kecajtop/ESPhome_led_stairs_controller/README.md

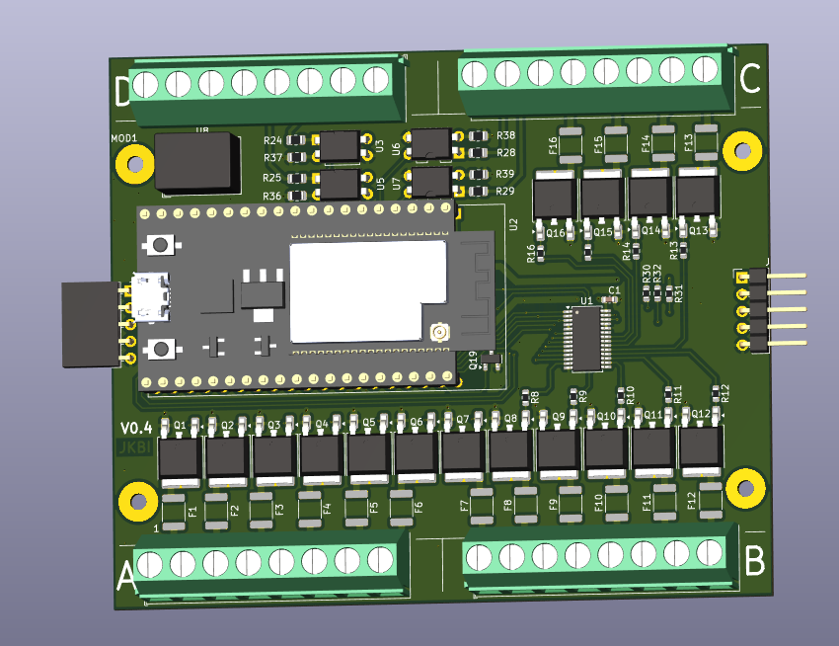
[picture p1: pic/View1.PNG]

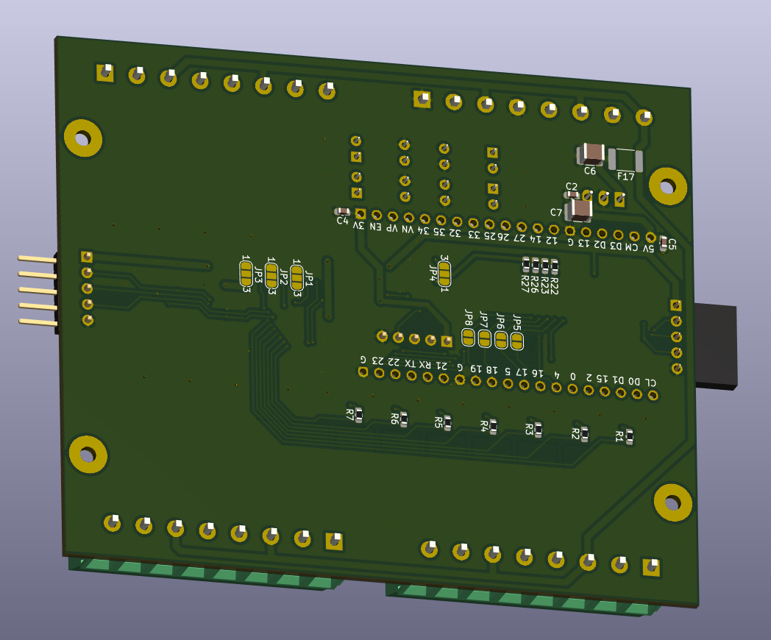
[picture p2: pic/View2.PNG]
