kecajtop/ESPhome_led_stairs_controller/pic/ESP32_boot_pins.png

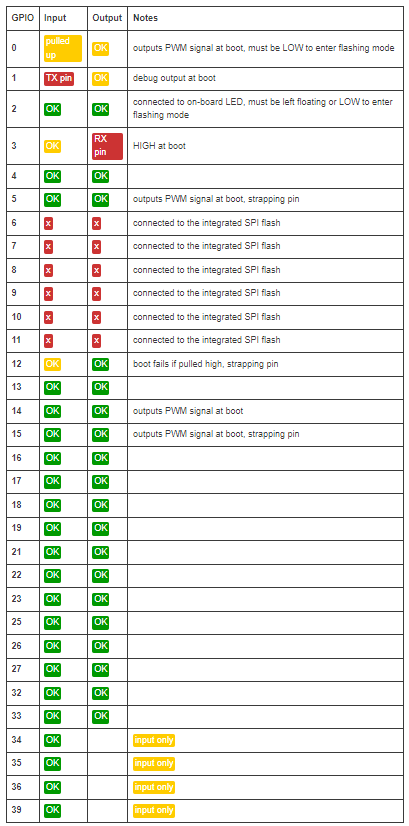
pic/ESP32_boot_pins.png
