kecajtop/ESPhome_led_stairs_controller/pic/ESP32_pinout.PNG

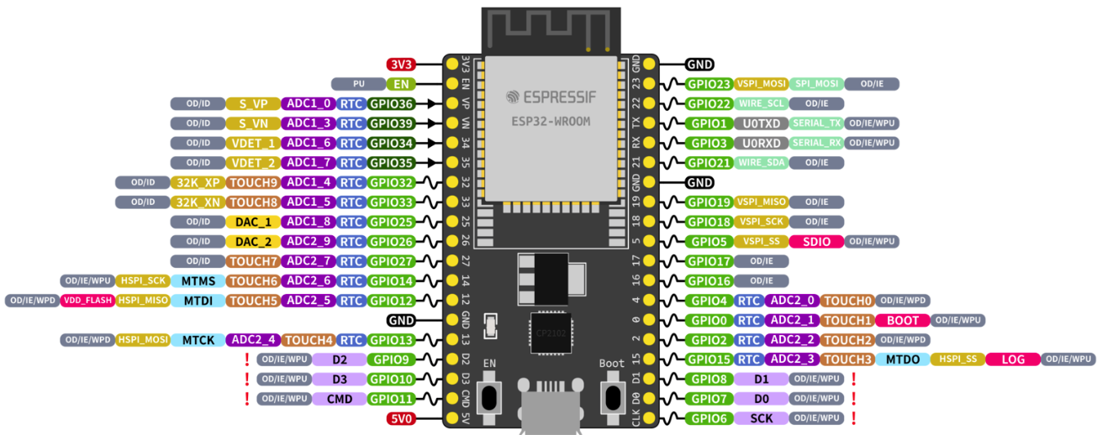
pic/ESP32_pinout.PNG
