kecajtop/ESPhome_led_stairs_controller/doc/ZD1006_Enclosure_components.pdf

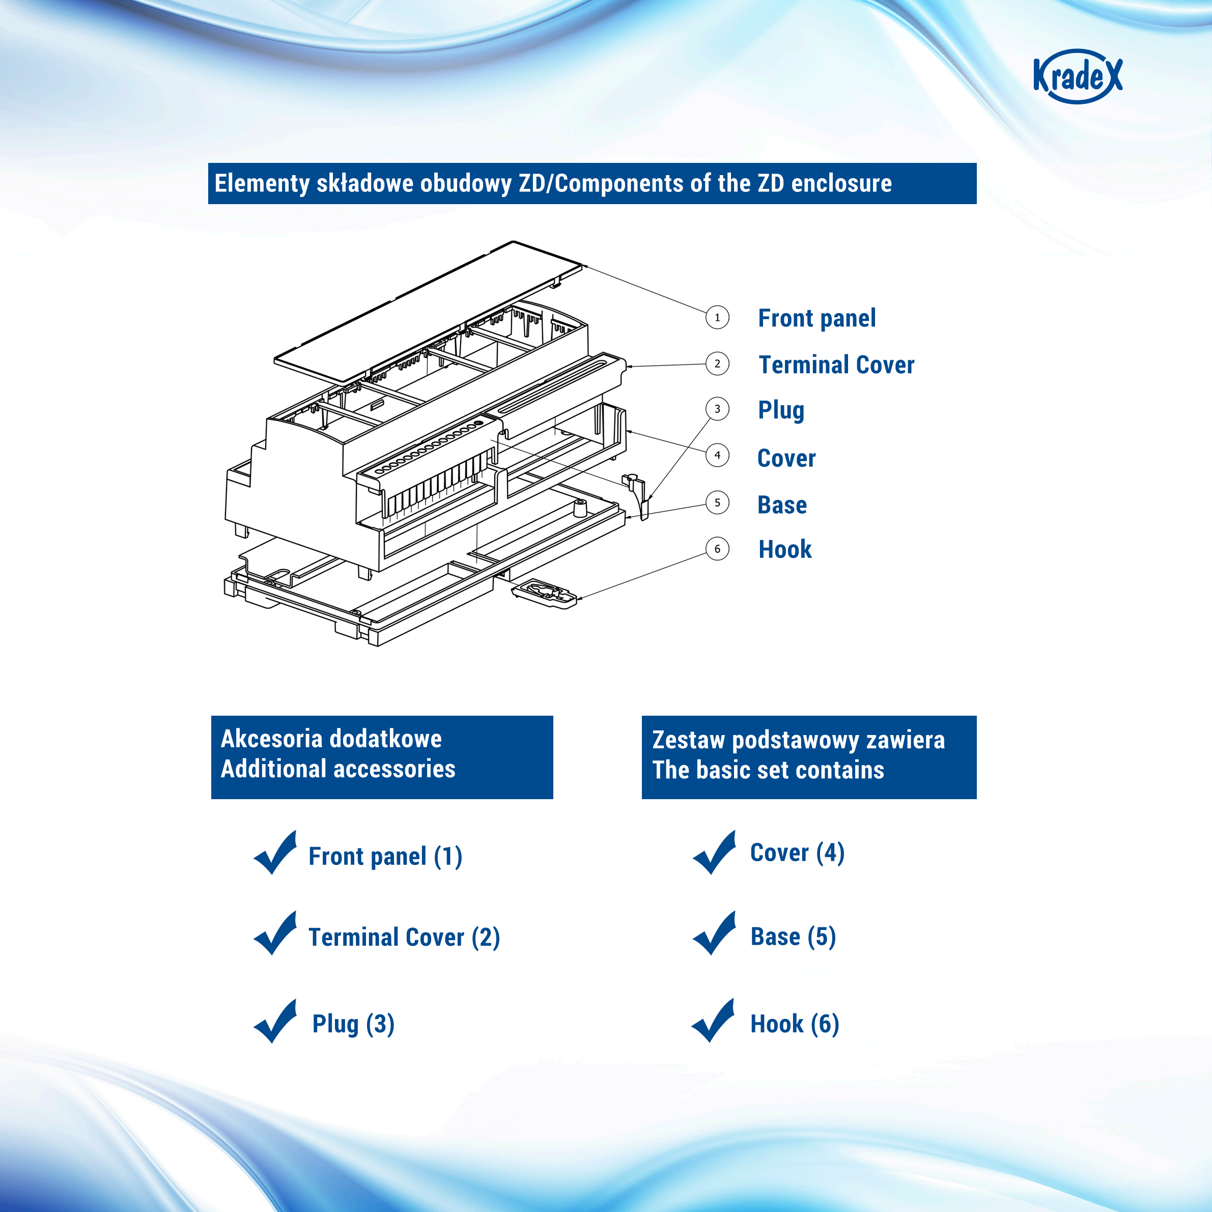
[picture p5: page 1]

Frontpanel
TerminalCover
Plug
Cover
Base
Hook

ElementyskładoweobudowyZD/ComponentsoftheZDenclosure

Cover(4)

Base(5)

Hook(6)

Zestawpodstawowyzawiera
Thebasicsetcontains

Frontpanel(1)

TerminalCover(2)

Plug(3)

Akcesoriadodatkowe
Additionalaccessories
