kecajtop/ESPhome_led_stairs_controller/hardware/schemat/V0.4/led_stairs_controller.pdf

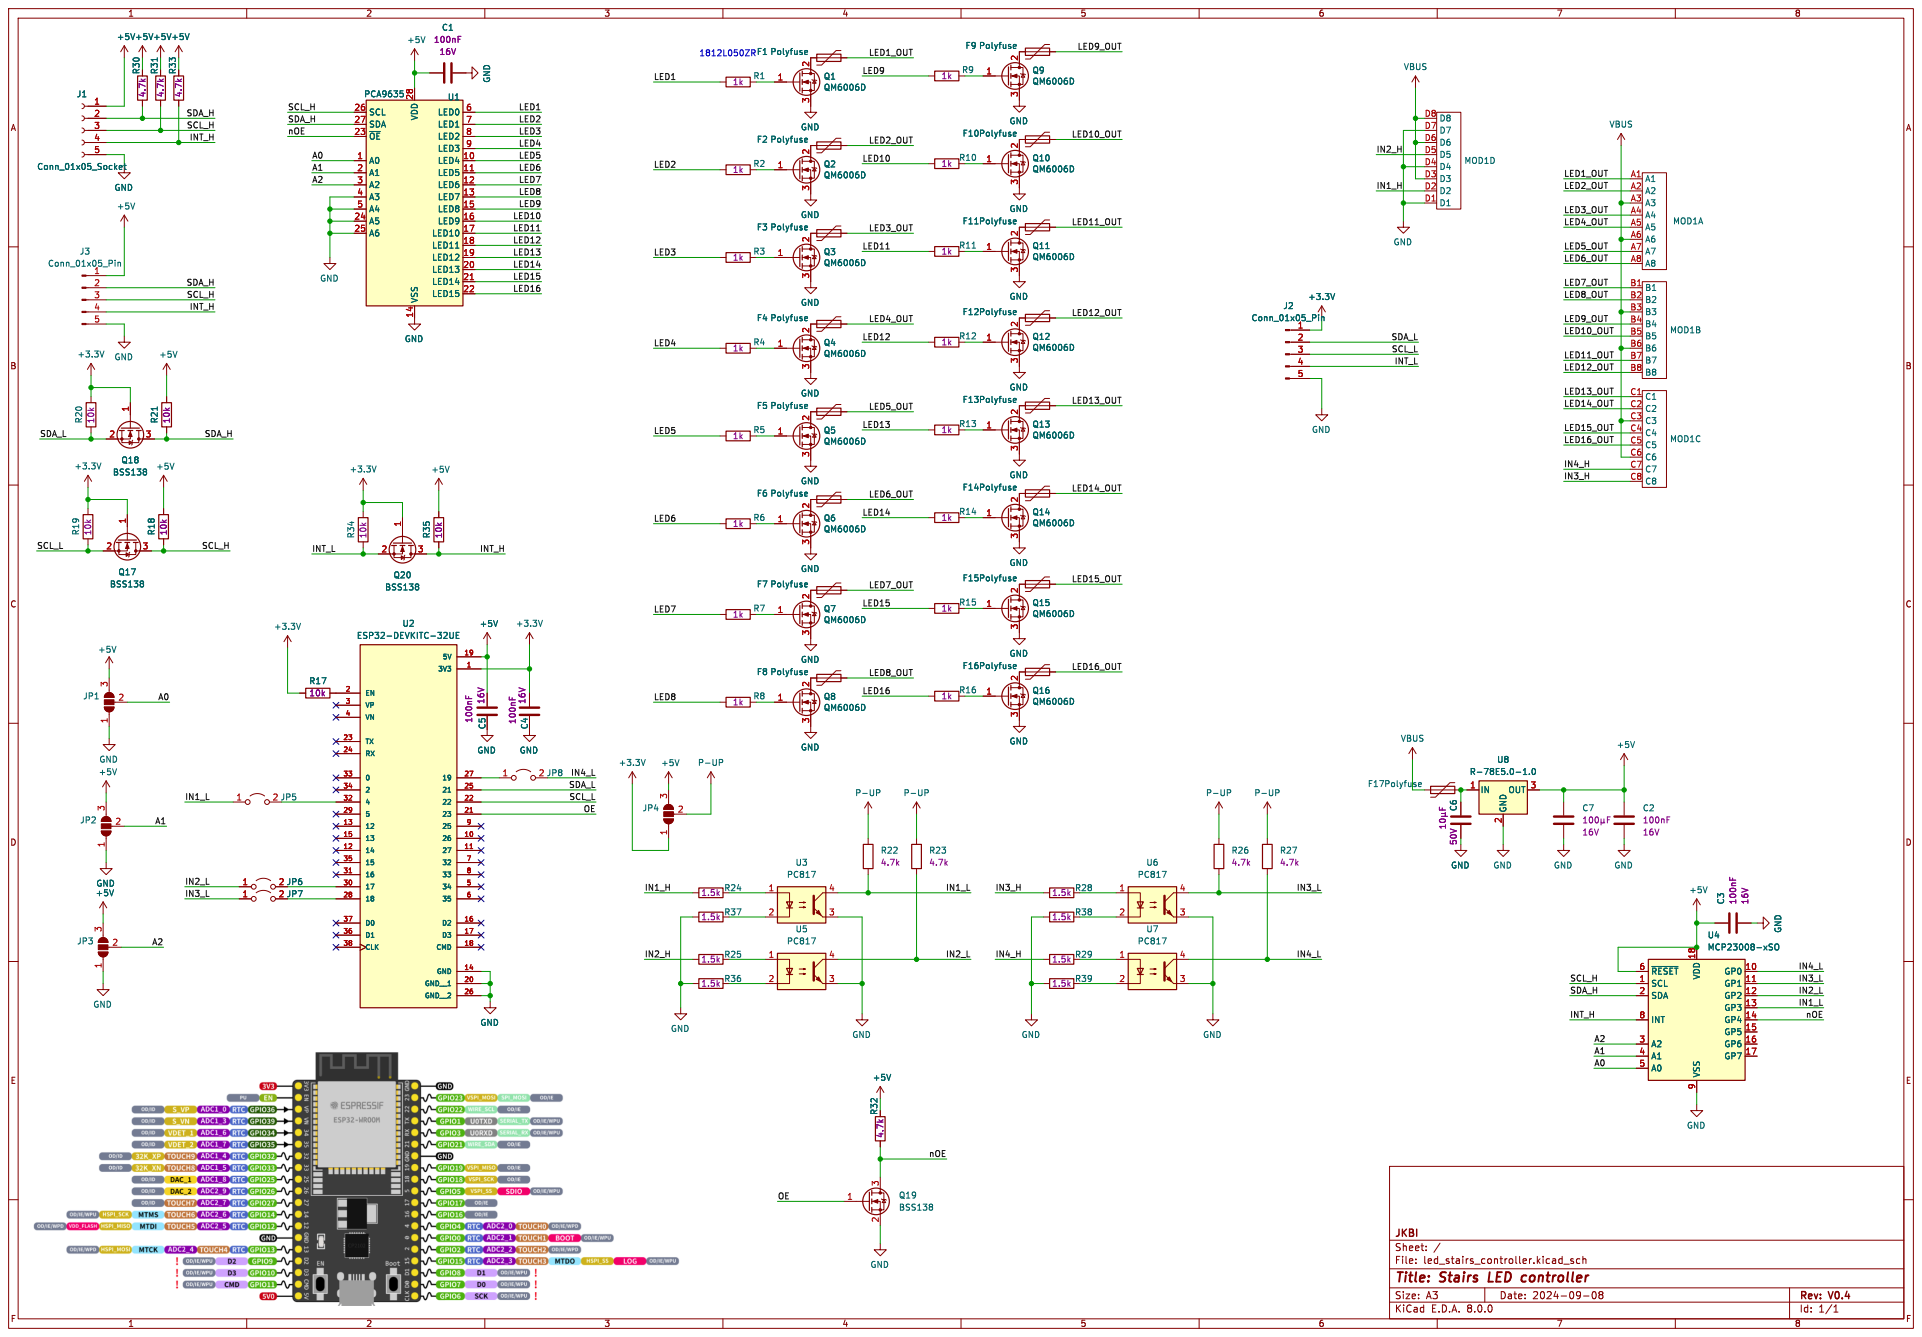
[picture p6: page 1]
