kecajtop/ESPhome_led_stairs_controller/doc/PŁYTKA_UNIWERSALNA_serii_ZD.pdf

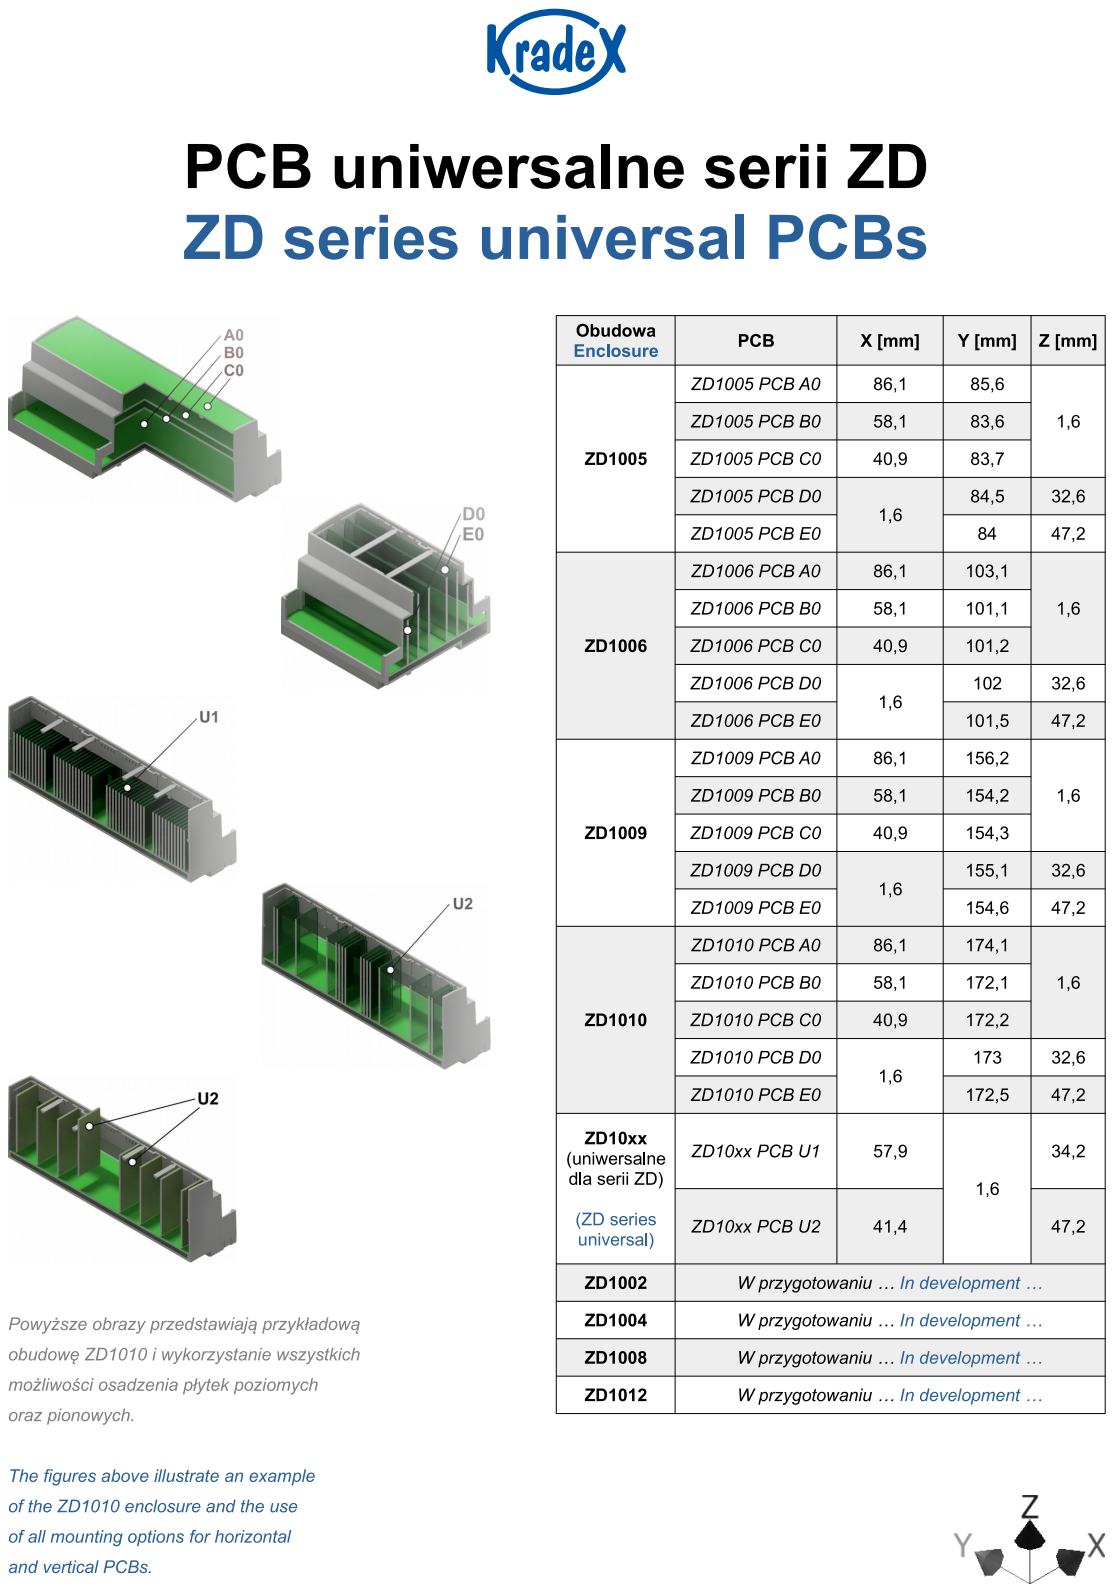
[picture p7: page 1]

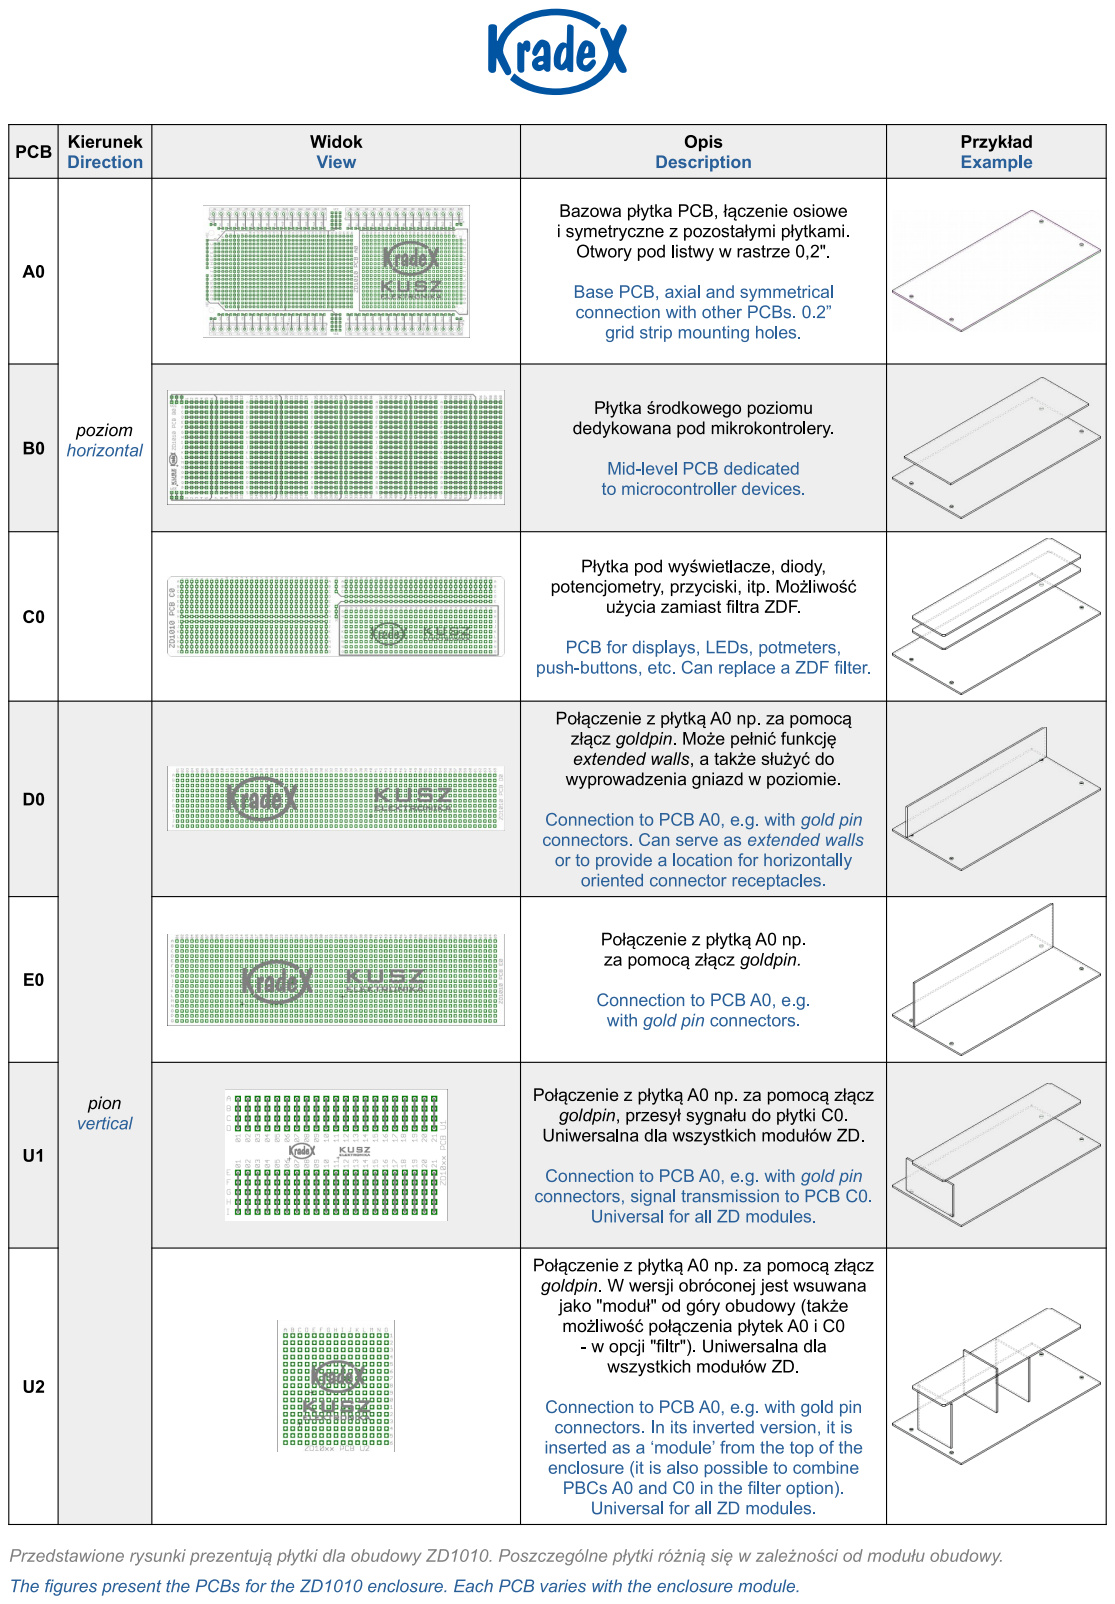
[picture p8: page 2]
