kecajtop/ESPhome_led_stairs_controller/hardware/led_stairs_controller.kicad_pcb

## KiCad design hardware/led_stairs_controller.kicad_pcb (2024-09-08)

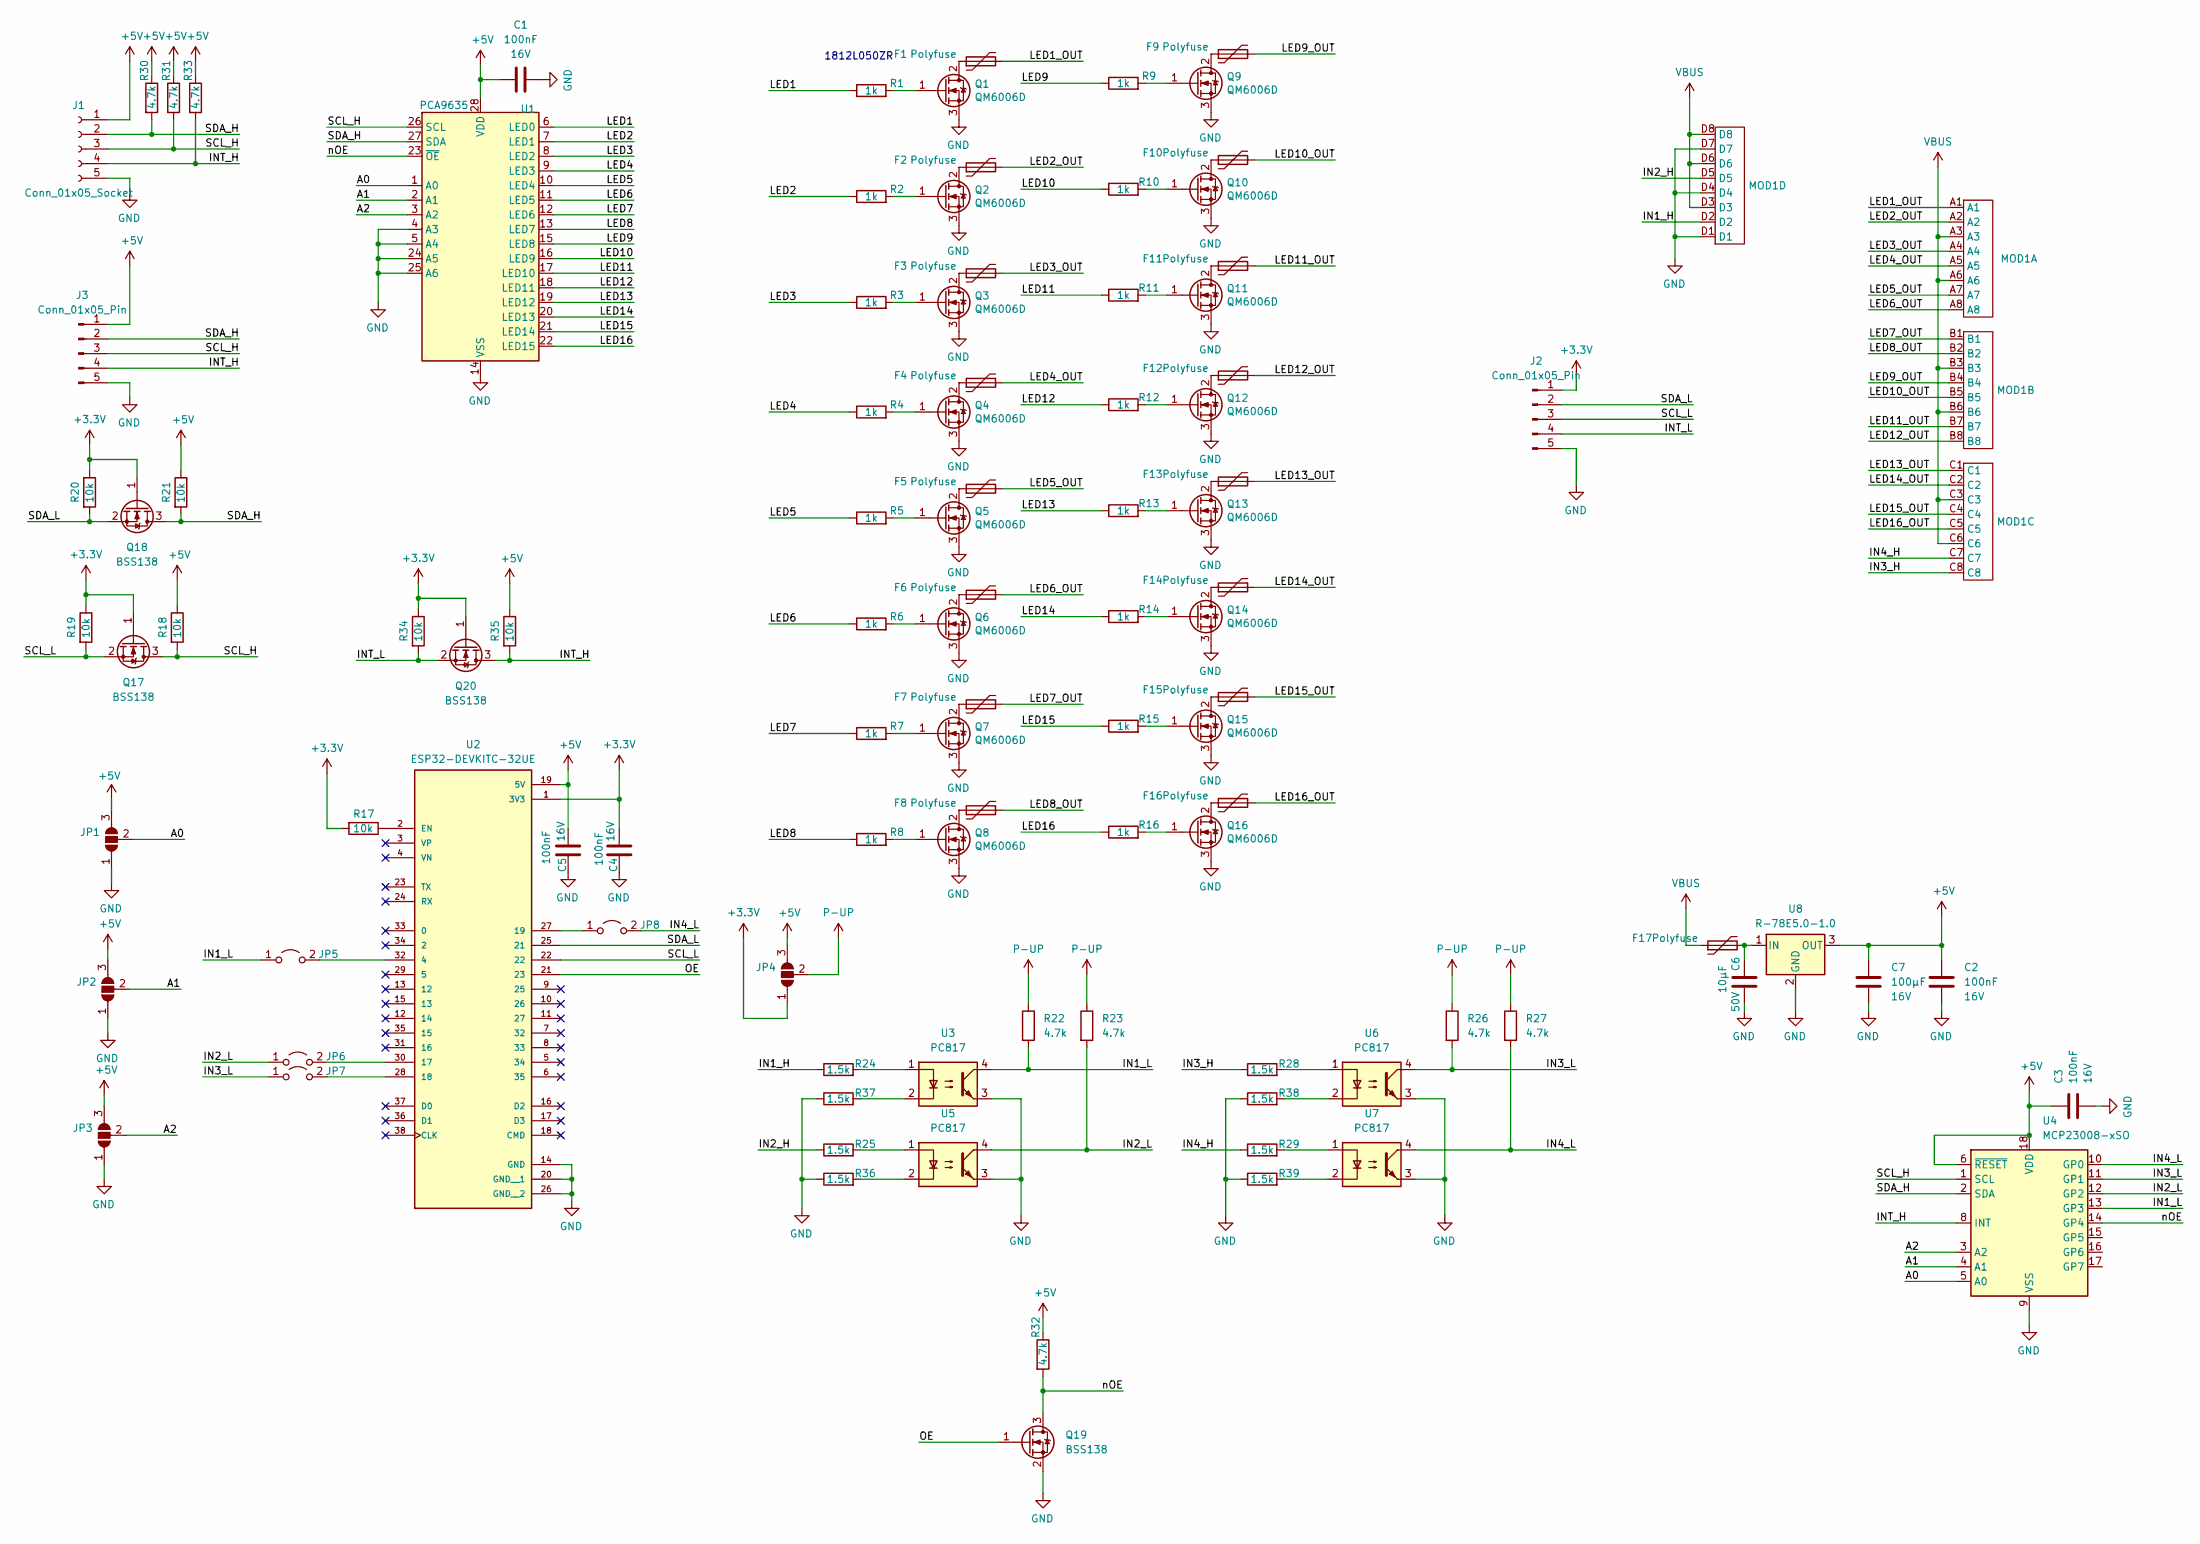
[picture p9: schematic led_stairs_controller.kicad_sch, Stairs LED controller]

Parts:
C1, C2, C3, C4, C5: C0603_100nF_16V_X7R; C_0603_1608Metric; Voltage 16V; Manufacturer Part Number C0603C104J4RACTU
C6: C1210_10µF_50V_X5R; C_1210_3225Metric; Voltage 50V; Manufacturer Part Number C1210C106K5PAC7210
C7: C1210_100µF_16V_X5R; C_1210_3225Metric; Voltage 16V; Manufacturer Part Number C1210C107M4PAC7800
F1, F2, F3, F4, F5, F6, F7, F8, F9, F10, F11, F12, F13, F14, F15, F16, F17: Polyfuse; Fuse_1812_4532Metric
J1: Conn_01x05_Socket; PinSocket_1x05_P2.54mm_Horizontal
J2: Conn_01x05_Pin; PinHeader_1x05_P2.54mm_Vertical
J3: Conn_01x05_Pin; PinHeader_1x05_P2.54mm_Horizontal
JP1, JP2, JP3, JP4: SolderJumper_3_Open; SolderJumper-3_P1.3mm_Open_RoundedPad1.0x1.5mm_NumberLabels
JP5, JP6, JP7, JP8: Jumper_2_Open; SolderJumper-2_P1.3mm_Open_RoundedPad1.0x1.5mm
MOD1: ZD1006
Q1, Q2, Q3, Q4, Q5, Q6, Q7, Q8, Q9, Q10, Q11, Q12, Q13, Q14, Q15, Q16: QM6006D; TO-252-2
Q17, Q18, Q19, Q20: BSS138; SOT-23
R1, R2, R3, R4, R5, R6, R7, R8, R9, R10, R11, R12, R13, R14, R15, R16: R0603_1k_1%_100mW_100PPM_AC; R_0603_1608Metric; Manufacturer Part Number AC0603FR-071KL
R17, R18, R19, R20, R21, R34, R35: R0603_10k_1%_100mW_100PPM_AC; R_0603_1608Metric; Manufacturer Part Number AC0603FR-0710KL
R22, R23, R26, R27, R30, R31, R32, R33: R0603_4.7k_1%_100mW_100PPM_AC; R_0603_1608Metric; Manufacturer Part Number AC0603FR-074K7L
R24, R25, R28, R29, R36, R37, R38, R39: R0805_1.5k_1%_125mW_100PPM_AC; R_0805_2012Metric; Manufacturer Part Number AC0805FR-071K5L
U1: PCA9635; TSSOP-28_4.4x9.7mm_P0.65mm
U2: ESP32-DEVKITC-32UE; ESPRESSIF_ESP32-DEVKITC-32UE; PARTREV V4
U3, U5, U6, U7: PC817; DIP-4_W7.62mm
U4: MCP23008-xSO; SOIC-18W_7.5x11.6mm_P1.27mm
U8: R-78E5.0-1.0; Converter_DCDC_RECOM_R-78E-0.5_THT

Connections:
+3.3V: C4.1, J2.1, JP4.1 (A), Q17.1 (G), Q18.1 (G), Q20.1 (G), R17.2, R19.1, R20.1, R34.1, U2.1 (3V3)
+5V: C1.1, C2.2, C3.2, C5.1, C7.1, J1.1, J3.1, JP1.3 (B), JP2.3 (B), JP3.3 (B), JP4.3 (B), R18.1, R21.1, R30.1, R31.1, R32.1, R33.1, R35.1, U1.28 (VDD), U2.19 (5V), U4.6 (~RESET), U4.18 (VDD), U8.3 (OUT)
/A0: JP1.2 (C), U1.1 (A0), U4.5 (A0)
/A1: JP2.2 (C), U1.2 (A1), U4.4 (A1)
/A2: JP3.2 (C), U1.3 (A2), U4.3 (A2)
/IN1_H: MOD1.D2, R24.1
/IN1_L: JP5.1 (A), R22.2, U3.4, U4.13 (GP3)
/IN2_H: MOD1.D5, R25.1
/IN2_L: JP6.1 (A), R23.2, U4.12 (GP2), U5.4
/IN3_H: MOD1.C8, R28.1
/IN3_L: JP7.1 (A), R26.2, U4.11 (GP1), U6.4
/IN4_H: MOD1.C7, R29.1
/IN4_L: JP8.2 (B), R27.2, U4.10 (GP0), U7.4
/INT_H: J1.4, J3.4, Q20.3 (D), R33.2, R35.2, U4.8 (INT)
/INT_L: J2.4, Q20.2 (S), R34.2
/LED1: R1.1, U1.6 (LED0)
/LED1_OUT: F1.2, MOD1.A1
/LED2: R2.1, U1.7 (LED1)
/LED2_OUT: F2.2, MOD1.A2
/LED3: R3.1, U1.8 (LED2)
/LED3_OUT: F3.2, MOD1.A4
/LED4: R4.1, U1.9 (LED3)
/LED4_OUT: F4.2, MOD1.A5
/LED5: R5.1, U1.10 (LED4)
/LED5_OUT: F5.2, MOD1.A7
/LED6: R6.1, U1.11 (LED5)
/LED6_OUT: F6.2, MOD1.A8
/LED7: R7.1, U1.12 (LED6)
/LED7_OUT: F7.2, MOD1.B1
/LED8: R8.1, U1.13 (LED7)
/LED8_OUT: F8.2, MOD1.B2
/LED9: R9.1, U1.15 (LED8)
/LED9_OUT: F9.2, MOD1.B4
/LED10: R10.1, U1.16 (LED9)
/LED10_OUT: F10.2, MOD1.B5
/LED11: R11.1, U1.17 (LED10)
/LED11_OUT: F11.2, MOD1.B7
/LED12: R12.1, U1.18 (LED11)
/LED12_OUT: F12.2, MOD1.B8
/LED13: R13.1, U1.19 (LED12)
/LED13_OUT: F13.2, MOD1.C1
/LED14: R14.1, U1.20 (LED13)
/LED14_OUT: F14.2, MOD1.C2
/LED15: R15.1, U1.21 (LED14)
/LED15_OUT: F15.2, MOD1.C4
/LED16: R16.1, U1.22 (LED15)
/LED16_OUT: F16.2, MOD1.C5
/OE: Q19.1 (G), U2.21 (23)
/SCL_H: J1.3, J3.3, Q17.3 (D), R18.2, R31.2, U1.26 (SCL), U4.1 (SCL)
/SCL_L: J2.3, Q17.2 (S), R19.2, U2.22
/SDA_H: J1.2, J3.2, Q18.3 (D), R21.2, R30.2, U1.27 (SDA), U4.2 (SDA)
/SDA_L: J2.2, Q18.2 (S), R20.2, U2.25 (21)
/nOE: Q19.3 (D), R32.2, U1.23 (~OE), U4.14 (GP4)
GND: C1.2, C2.1, C3.1, C4.2, C5.2, C6.2, C7.2, J1.5, J2.5, J3.5, JP1.1 (A), JP2.1 (A), JP3.1 (A), MOD1.D1, MOD1.D4, MOD1.D7, Q1.3 (S), Q2.3 (S), Q3.3 (S), Q4.3 (S), Q5.3 (S), Q6.3 (S), Q7.3 (S), Q8.3 (S), Q9.3 (S), Q10.3 (S), Q11.3 (S), Q12.3 (S), Q13.3 (S), Q14.3 (S), Q15.3 (S), Q16.3 (S), Q19.2 (S), R36.1, R37.1, R38.1, R39.1, U1.4 (A3), U1.5 (A4), U1.14 (VSS), U1.24 (A5), U1.25 (A6), U2.14 (GND), U2.20 (GND__1), U2.26 (GND__2), U3.3, U4.9 (VSS), U5.3, U6.3, U7.3, U8.2 (GND)
unnamed: JP5.2 (B), U2.32 (4)
unnamed: JP6.2 (B), U2.30 (17)
unnamed: JP7.2 (B), U2.28 (18)
unnamed: JP8.1 (A), U2.27 (19)
unnamed: F1.1, Q1.2 (D)
unnamed: Q1.1 (G), R1.2
unnamed: F2.1, Q2.2 (D)
unnamed: Q2.1 (G), R2.2
unnamed: F3.1, Q3.2 (D)
unnamed: Q3.1 (G), R3.2
unnamed: F4.1, Q4.2 (D)
unnamed: Q4.1 (G), R4.2
unnamed: F5.1, Q5.2 (D)
unnamed: Q5.1 (G), R5.2
unnamed: F6.1, Q6.2 (D)
unnamed: Q6.1 (G), R6.2
unnamed: F7.1, Q7.2 (D)
unnamed: Q7.1 (G), R7.2
unnamed: F8.1, Q8.2 (D)
unnamed: Q8.1 (G), R8.2
unnamed: F9.1, Q9.2 (D)
unnamed: Q9.1 (G), R9.2
unnamed: F10.1, Q10.2 (D)
unnamed: Q10.1 (G), R10.2
unnamed: F11.1, Q11.2 (D)
unnamed: Q11.1 (G), R11.2
unnamed: F12.1, Q12.2 (D)
unnamed: Q12.1 (G), R12.2
unnamed: F13.1, Q13.2 (D)
unnamed: Q13.1 (G), R13.2
unnamed: F14.1, Q14.2 (D)
unnamed: Q14.1 (G), R14.2
unnamed: F15.1, Q15.2 (D)
unnamed: Q15.1 (G), R15.2
unnamed: F16.1, Q16.2 (D)
unnamed: Q16.1 (G), R16.2
unnamed: R24.2, U3.1
unnamed: R25.2, U5.1
unnamed: R28.2, U6.1
unnamed: R29.2, U7.1
unnamed: R36.2, U5.2
unnamed: R37.2, U3.2
unnamed: R38.2, U6.2
unnamed: R39.2, U7.2
unnamed: R17.1, U2.2 (EN)
unnamed: C6.1, F17.2, U8.1 (IN)
P-UP: JP4.2 (C), R22.1, R23.1, R26.1, R27.1
VBUS: F17.1, MOD1.A3, MOD1.A6, MOD1.B3, MOD1.B6, MOD1.C3, MOD1.C6, MOD1.D3, MOD1.D6, MOD1.D8

Notes on the sheet:
1812L050ZR

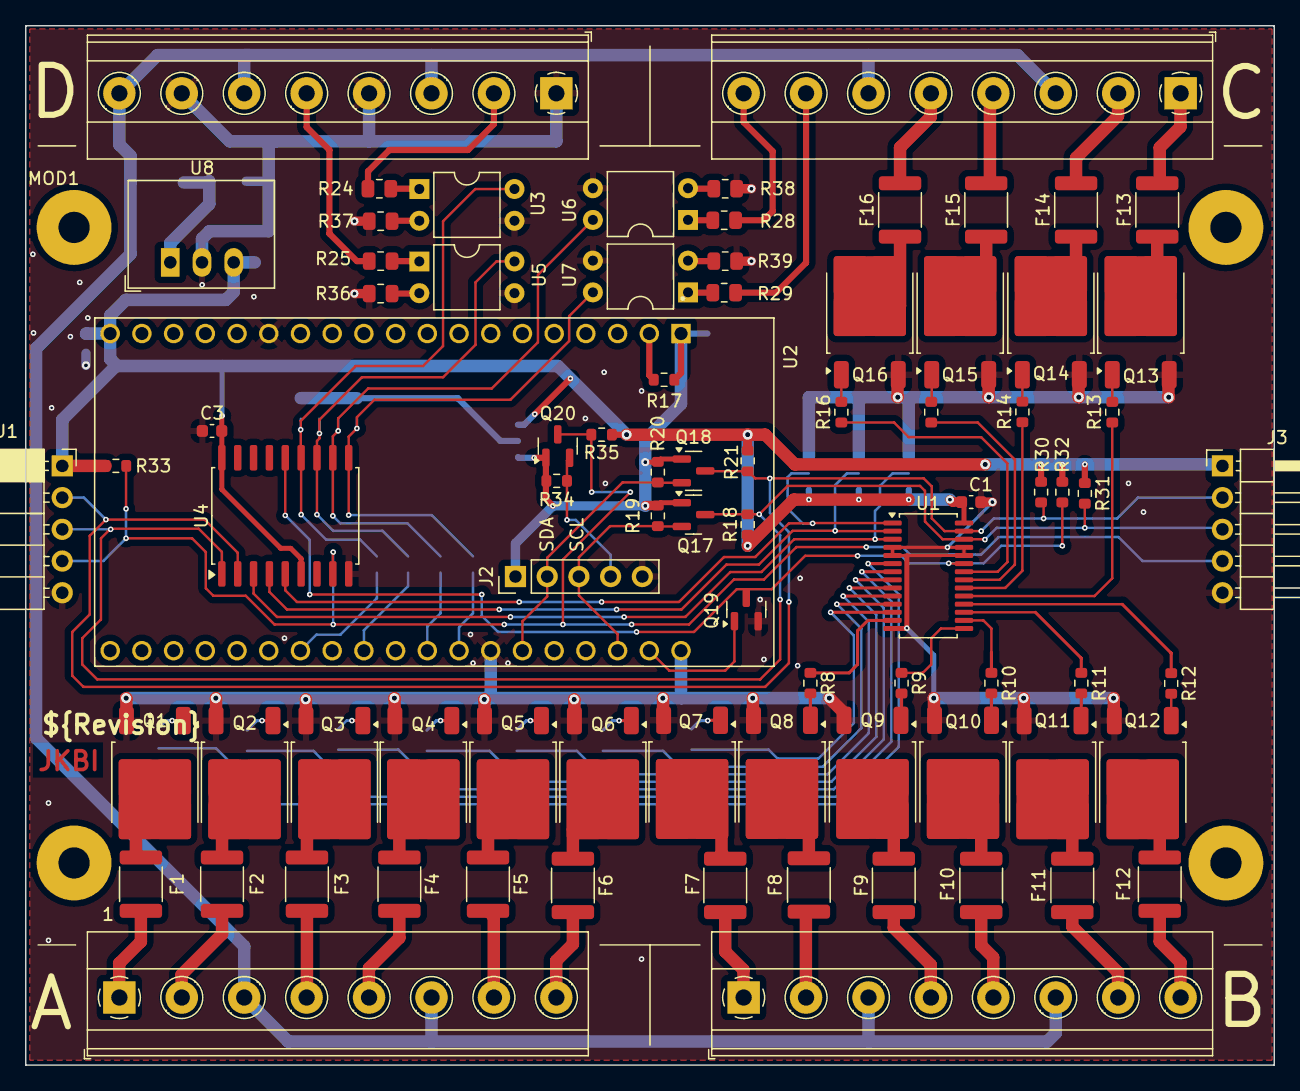
[picture p10: board led_stairs_controller.kicad_pcb from above]

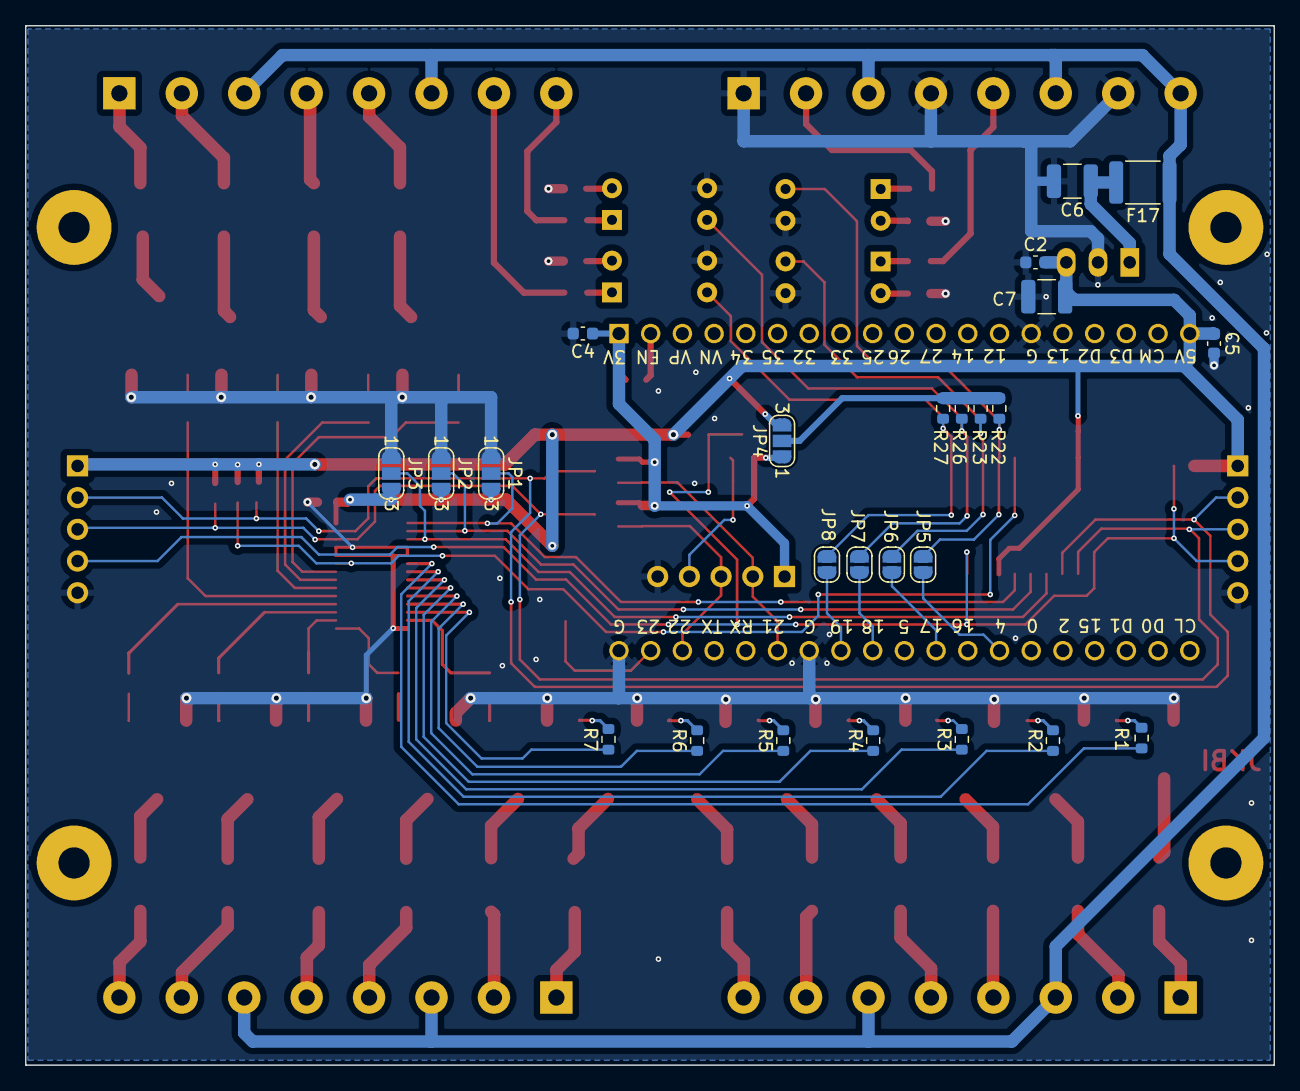
[picture p11: board led_stairs_controller.kicad_pcb from below]

Board: 2 copper layers, 100.0 x 83.2 mm, 103 parts (25 on the bottom side), 102 nets.
