kecajtop/ESPhome_led_stairs_controller/(commit log)

2024-02-02 Initial commit
    Initial commit
    [led_stairs_controller.kicad_pcb, led_stairs_controller.kicad_sch]
2024-02-02 update
    update
    [led_stairs_controller.kicad_pcb, led_stairs_controller.kicad_sch]
2024-08-19 step file added
    [led_stairs_controller.kicad_pcb]
